harry10086/InkWord_ESP32/HW/InkWordESP32_MB_V1.1/jlcpcb/production_files/BOM-InkWordESP32_MB_V1.1.csv

Comment | Designator | Footprint | LCSC | Quantity
0R | R7,R8 | R0603 | C100044 | 2
100nF ±10% 50V | C1,C11,C2,C20,C22,C24,C25,C26,C27,C35,C37,C6,C7 | C0603 | C14663 | 13
100uH | L1 | LQH3NPZ101MMEL | C703088 | 1
10kΩ | R13,R14,R15,R16,R17,R18,R22,R26,R29,R30,R34,R38,R4,R6,R9 | R0603 | C25804 | 15
10uF 10V | C10,C13,C21,C23,C3 | C0603 | C19702 | 5
10uF 50V | C19 | C0805 | C2932476 | 1
10Ω | R19,R20,R21,R23,R24,R25,R36,R37 | R0603 | C109318 | 8
1MΩ ±1% | R12 | R0603 | C22935 | 1
1kΩ | R1 | R0603 | C22548 | 1
1uF | C12,C14,C15,C16,C17,C4,C5,C8,C9 | C0603 | C15849 | 9
33Ω | R27 | R0603 | C23140 | 1
3MΩ ±1% | R11 | R0603 | C23156 | 1
3kΩ ±1% | R5 | R0603 | C4211 | 1
3Ω | R10 | R0603 | C22356394 | 1
4.7uF | C18 | C0603 | C69335 | 1
5.1kΩ ±1% | R2,R3 | R0603 | C23186 | 2
600Ω@100MHz | FB1 | L0603 | C1002 | 1
AFC04-S24FCA-00 | FPC1 | AFC04-S24FCA-00 | C883632 | 1
B5819WS | D4,D5,D6 | B5819WS | C7420331 | 3
BSMD0603L-100 | F1,F2 | Fuse_0603_1608Metric | C2757929 | 2
ESP32-S3-WROOM-1_N16R8 | U4 | ESP32-S3-WROOM-1_N16R8 | C2913202 | 1
GT-L5.2-W5.2-H015 | SW1,SW2 | SW-SMD_4P-L5.2-W5.2-P3.70-LS6.4 | C29780122 | 2
RCLAMP0521P-N | D10,D11,D12,D13,D14,D15,D17,D7,D8,D9 | RCLAMP0521P-N | C316043 | 10
RCLAMP0521T-ES | D1,D2,D3 | DFN1006-2L | C5180263 | 3
SI1308EDL-T1-GE3 | Q1 | SI1308EDL-T1-GE3 | C469327 | 1
SS12D10G6-WJ | S1 | SS12D10G6-WJ | C7431059 | 1
TF-CARD_H1_8 | TF1 | TF-CARD_H1_8 | C7529389 | 1
TP4055 | U2 | SOT-23-5_L3.0-W1.7-P0.95-LS2.8-BL | C28441 | 1
TS-1009B-05026 | K1,K2,K3 | TS-1009B-05026 | C455252 | 3
TYPE-C16PIN | USB1 | TYPE-C16PIN | C393939 | 1
XB6366D | U1 | XB6366D | C2760016 | 1
XC6220B331MR-G | U3 | XC6220B331MR-G | C86534 | 1
ZX-XH2.54-2PWZ | CN1 | CONN-TH_2P-P2.50_ZX-XH2.54-2PWZ | C7429641 | 1
ZX-XH2.54-3PZZ |  | CONN-TH_3P-P2.54_2501S-3P | C7429633 | 0
