harry10086/InkWord_ESP32/MD/inkword_v1.1/InkWord-fastener.SLDPRT

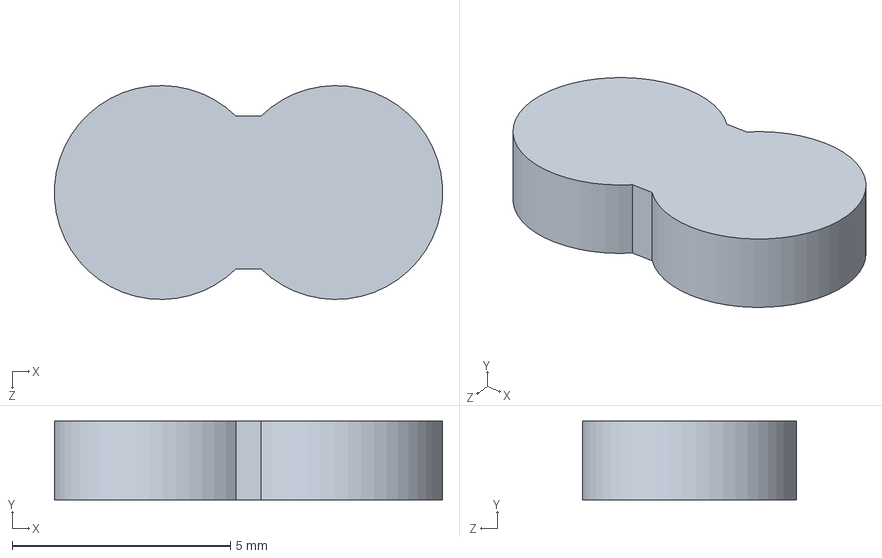
[picture p1: CAD file, 2026-10-13]
MD/inkword_v1.1/InkWord-fastener.SLDPRT
8.89 x 1.80 x 4.90 mm
