harry10086/InkWord_ESP32/MD/inkword_v1.1/InkWord-bottom.SLDPRT

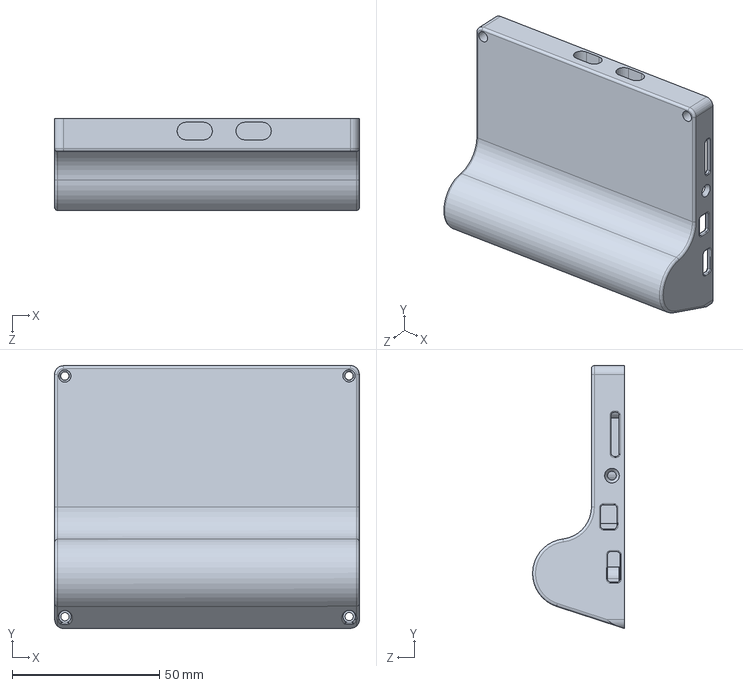
[picture p2: CAD file, 2026-10-13]
MD/inkword_v1.1/InkWord-bottom.SLDPRT
103.6 x 89.3 x 31.2 mm
