harry10086/InkWord_ESP32/MD/inkword_v1.1/InkWord-top.SLDPRT

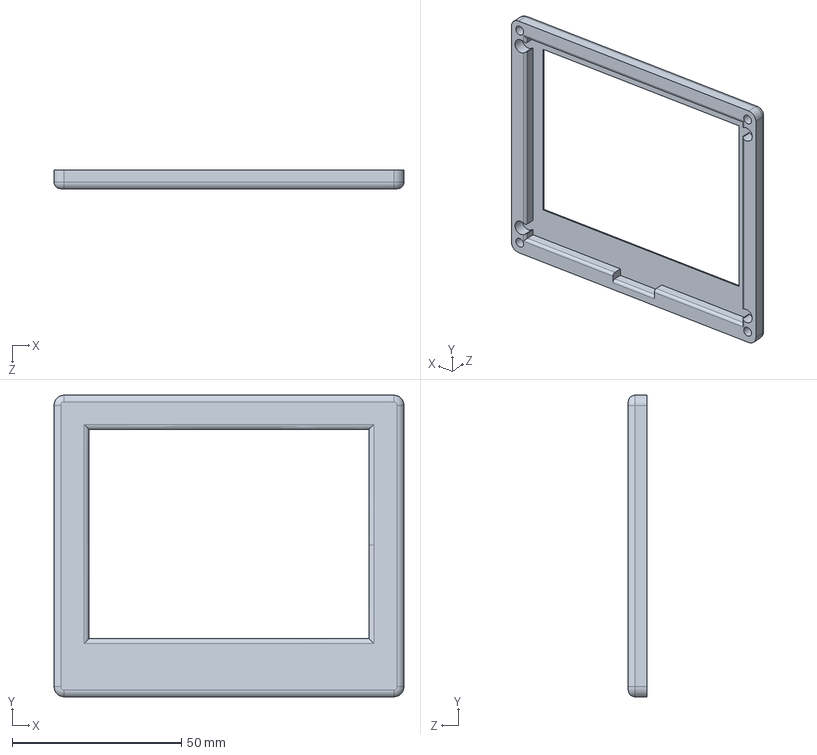
[picture p3: CAD file, 2026-10-13]
MD/inkword_v1.1/InkWord-top.SLDPRT
103.5 x 89.3 x 5.50 mm
