harry10086/InkWord_ESP32/MD/inkword_v1.1/InkWord-spring.SLDPRT

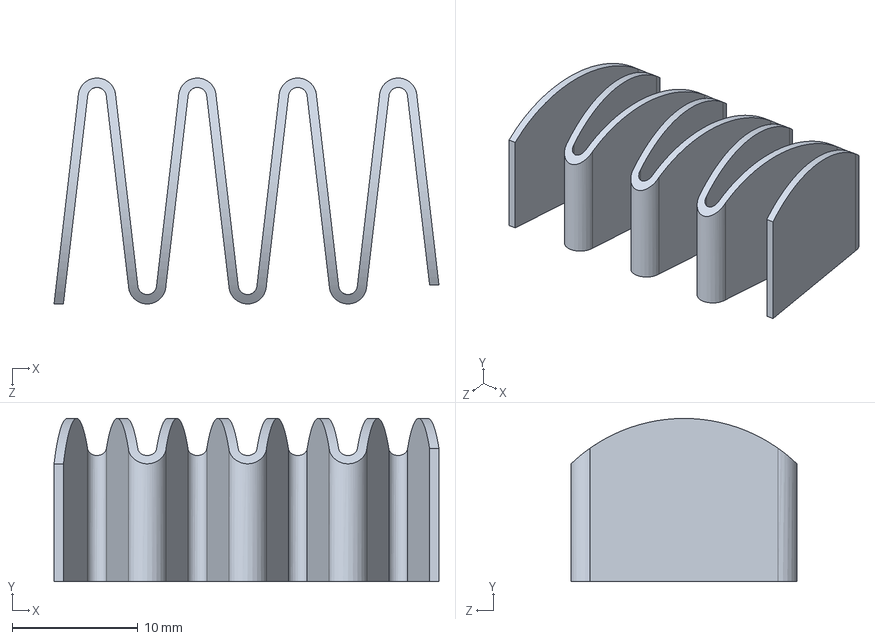
[picture p4: CAD file, 2026-10-13]
MD/inkword_v1.1/InkWord-spring.SLDPRT
30.7 x 13.0 x 18.0 mm
