harry10086/InkWord_ESP32/MD/inkword_v1.1/InkWord-button.SLDPRT

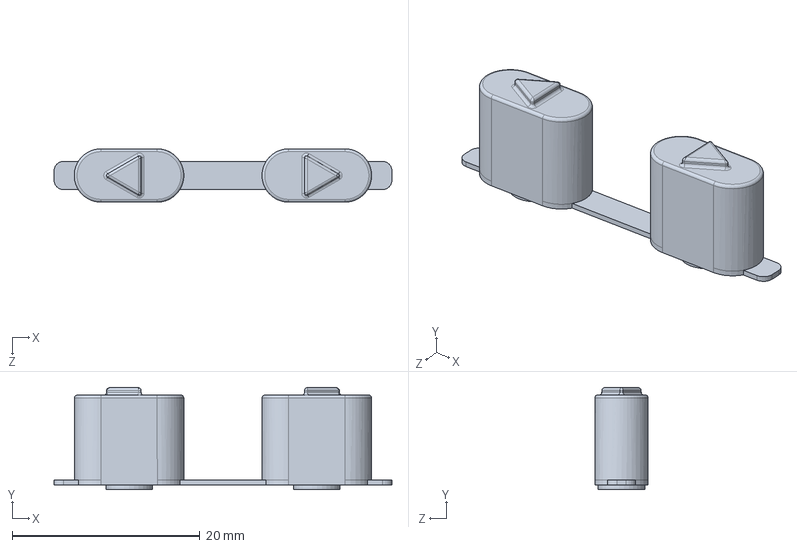
[picture p5: CAD file, 2026-10-13]
MD/inkword_v1.1/InkWord-button.SLDPRT
36.0 x 10.9 x 5.68 mm
