harry10086/InkWord_ESP32/MD/inkword_v1.1/ink.SLDPRT

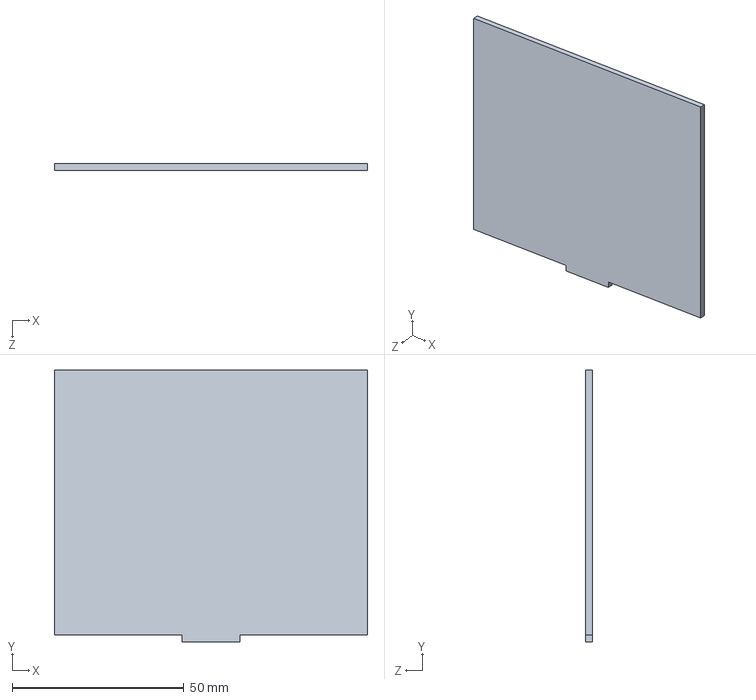
[picture p6: CAD file, 2026-10-13]
MD/inkword_v1.1/ink.SLDPRT
91.0 x 79.0 x 1.90 mm
