harry10086/InkWord_ESP32/HW/InkWordESP32_MB_V1.1/InkWordESP32_MB_V1.1.kicad_pcb

## KiCad design HW/InkWordESP32_MB_V1.1/InkWordESP32_MB_V1.1.kicad_pcb (2026-10-13)

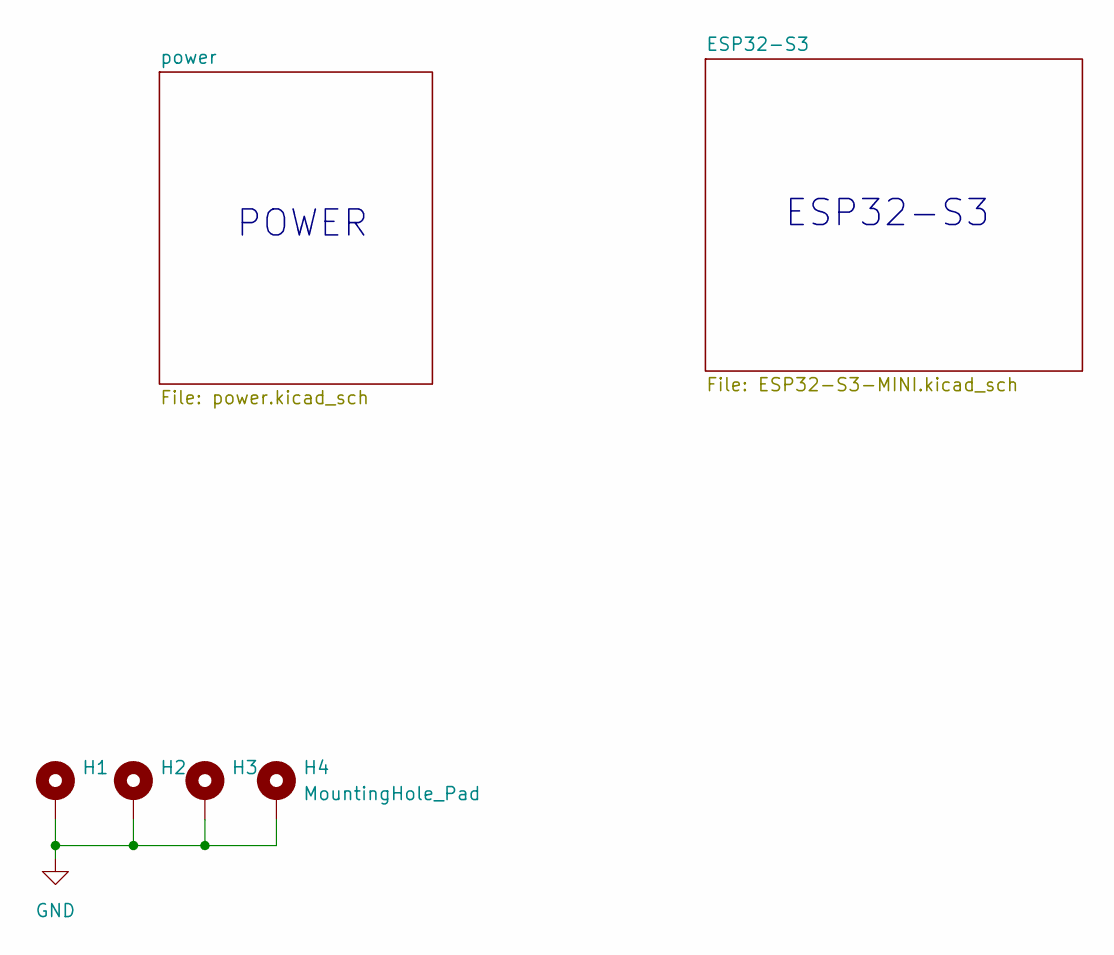
[picture p7: schematic InkWordESP32_MB_V1.1.kicad_sch]

Parts:
H1, H2, H3, H4: MountingHole_Pad; MountingHole_3.2mm_M3_Pad_Via

Connections:
GND: H1.1 (1_1), H2.1 (1_1), H3.1 (1_1), H4.1 (1_1); also elsewhere on the board

Notes on the sheet:
POWER
ESP32-S3

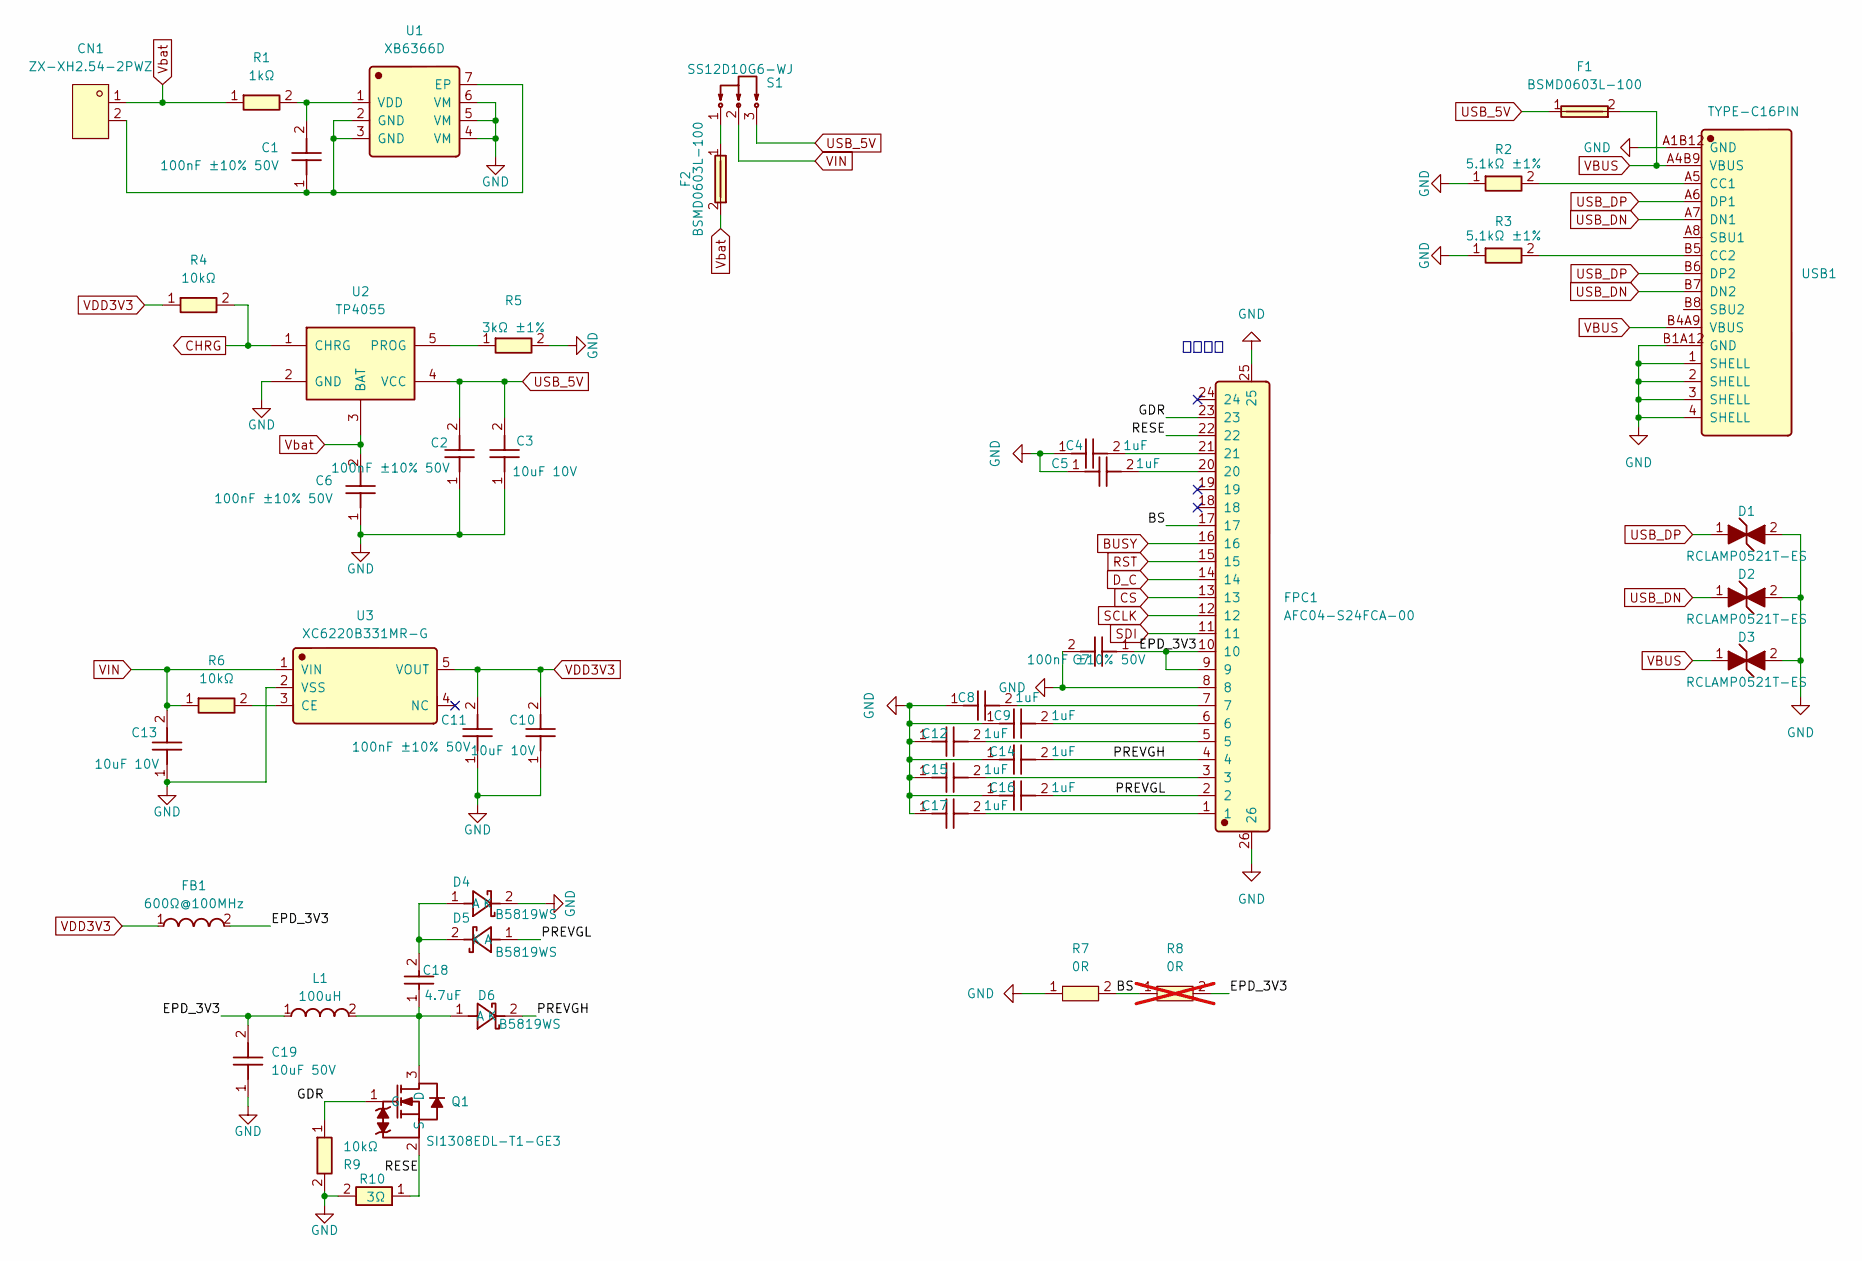
[picture p8: schematic power.kicad_sch]

Parts:
C1, C2, C6, C7, C11: 100nF ±10% 50V; C0603; Manufacturer Part CC0603KRX7R9BB104; LCSC C14663
C3, C10, C13: 10uF 10V; C0603; Manufacturer Part CL10A106KP8NNNC; LCSC C19702
C4, C5, C8, C9, C12, C14, C15, C16, C17: 1uF; C0603; Manufacturer Part CL10A105KB8NNNC; LCSC C15849
C18: 4.7uF; C0603; Manufacturer Part CL10A475KA8NQNC; LCSC C69335
C19: 10uF 50V; C0805; Manufacturer Part CL21A106KBYQNNE; LCSC C2932476
CN1: ZX-XH2.54-2PWZ; CONN-TH_2P-P2.50_ZX-XH2.54-2PWZ; LCSC Part C7429641
D1, D2, D3: RCLAMP0521T-ES; DFN1006-2L; Manufacturer Part RCLAMP0521T-ES; LCSC C5180263
D4, D5, D6: B5819WS; Manufacturer Part B5819WS; LCSC C7420331
F1, F2: BSMD0603L-100; Fuse_0603_1608Metric; Manufacturer Part BSMD0603L-100; LCSC C2757929
FB1: 600Ω@100MHz; L0603; Manufacturer Part GZ1608D601TF; LCSC C1002
FPC1: AFC04-S24FCA-00; Manufacturer Part AFC04-S24FCA-00; LCSC C883632
L1: 100uH; LQH3NPZ101MMEL; Manufacturer Part LQH3NPZ101MMEL; LCSC C703088
Q1: SI1308EDL-T1-GE3; Manufacturer Part SI1308EDL-T1-GE3; LCSC C469327
R1: 1kΩ; R0603; Manufacturer Part 0603WAF1001T5E; LCSC C21190
R2, R3: 5.1kΩ ±1%; R0603; Manufacturer Part 0603WAF5101T5E; LCSC C23186
R4, R6, R9: 10kΩ; R0603; Manufacturer Part 0603WAF1002T5E; LCSC C25804
R5: 3kΩ ±1%; R0603; Manufacturer Part 0603WAF3001T5E; LCSC C4211
R7: 0R; R0603; LCSC Part C100044
R8: 0R; R0603; LCSC Part C100044; not fitted
R10: 3Ω; R0603; Manufacturer Part RCA033RFLF; LCSC C22356394
S1: SS12D10G6-WJ; Manufacturer Part SS12D10G6-WJ; LCSC C7431059
U1: XB6366D; Manufacturer Part XB6366D; LCSC C2760016
U2: TP4055; SOT-23-5_L3.0-W1.7-P0.95-LS2.8-BL; Manufacturer Part TP4055; LCSC C28441
U3: XC6220B331MR-G; Manufacturer Part XC6220B331MR-G; LCSC C86534
USB1: TYPE-C16PIN; Manufacturer Part TYPE-C16PIN; LCSC C393939

Connections:
/power/BS: FPC1.17, R7.2, R8.1
/power/EPD_3V3: C7.1, C19.2, FB1.2, FPC1.9, FPC1.10, L1.1, R8.2
/power/GDR: FPC1.23, Q1.1 (G), R9.1
/power/PREVGH: C14.2, D6.2 (K), FPC1.4
/power/PREVGL: C16.2, D5.1 (A), FPC1.2
/power/RESE: FPC1.22, Q1.2 (S), R10.1
BUSY: FPC1.16; also elsewhere on the board
CHRG: R4.2, U2.1 (CHRG); also elsewhere on the board
CS: FPC1.13; also elsewhere on the board
D_C: FPC1.14; also elsewhere on the board
GND: C2.1, C3.1, C4.1, C5.1, C6.1, C7.2, C8.1, C9.1, C10.1, C11.1, C12.1, C13.1, C14.1, C15.1, C16.1, C17.1, C19.1, D1.2, D2.2, D3.2, D4.2 (K), FPC1.8, FPC1.25, FPC1.26, R2.1, R3.1, R5.2, R7.1, R9.2, R10.2, U1.4 (VM), U1.5 (VM), U1.6 (VM), U2.2 (GND), U3.2 (VSS), USB1.1 (SHELL), USB1.2 (SHELL), USB1.3 (SHELL), USB1.4 (SHELL), USB1.A1B12 (GND), USB1.B1A12 (GND); also elsewhere on the board
unnamed: C4.2, FPC1.21
unnamed: C5.2, FPC1.20
unnamed: C8.2, FPC1.7
unnamed: C9.2, FPC1.6
unnamed: C12.2, FPC1.5
unnamed: C15.2, FPC1.3
unnamed: C17.2, FPC1.1
unnamed: C18.2, D4.1 (A), D5.2 (K)
unnamed: C18.1, D6.1 (A), L1.2, Q1.3 (D)
unnamed: F2.1, S1.1
unnamed: C1.1, CN1.2, U1.2 (GND), U1.3 (GND), U1.7 (EP)
unnamed: C1.2, R1.2, U1.1 (VDD)
unnamed: R5.1, U2.5 (PROG)
unnamed: R6.2, U3.3 (CE)
unnamed: R2.2, USB1.A5 (CC1)
unnamed: R3.2, USB1.B5 (CC2)
RST: FPC1.15; also elsewhere on the board
SCLK: FPC1.12; also elsewhere on the board
SDI: FPC1.11; also elsewhere on the board
USB_5V: C2.2, C3.2, F1.1, S1.3, U2.4 (VCC)
USB_DN: D2.1, USB1.A7 (DN1), USB1.B7 (DN2); also elsewhere on the board
USB_DP: D1.1, USB1.A6 (DP1), USB1.B6 (DP2); also elsewhere on the board
VBUS: D3.1, F1.2, USB1.A4B9 (VBUS), USB1.B4A9 (VBUS)
VDD3V3: C10.2, C11.2, FB1.1, R4.1, U3.5 (VOUT); also elsewhere on the board
VIN: C13.2, R6.1, S1.2, U3.1 (VIN); also elsewhere on the board
Vbat: C6.2, CN1.1, F2.2, R1.1, U2.3 (BAT)

Notes on the sheet:
排线下接

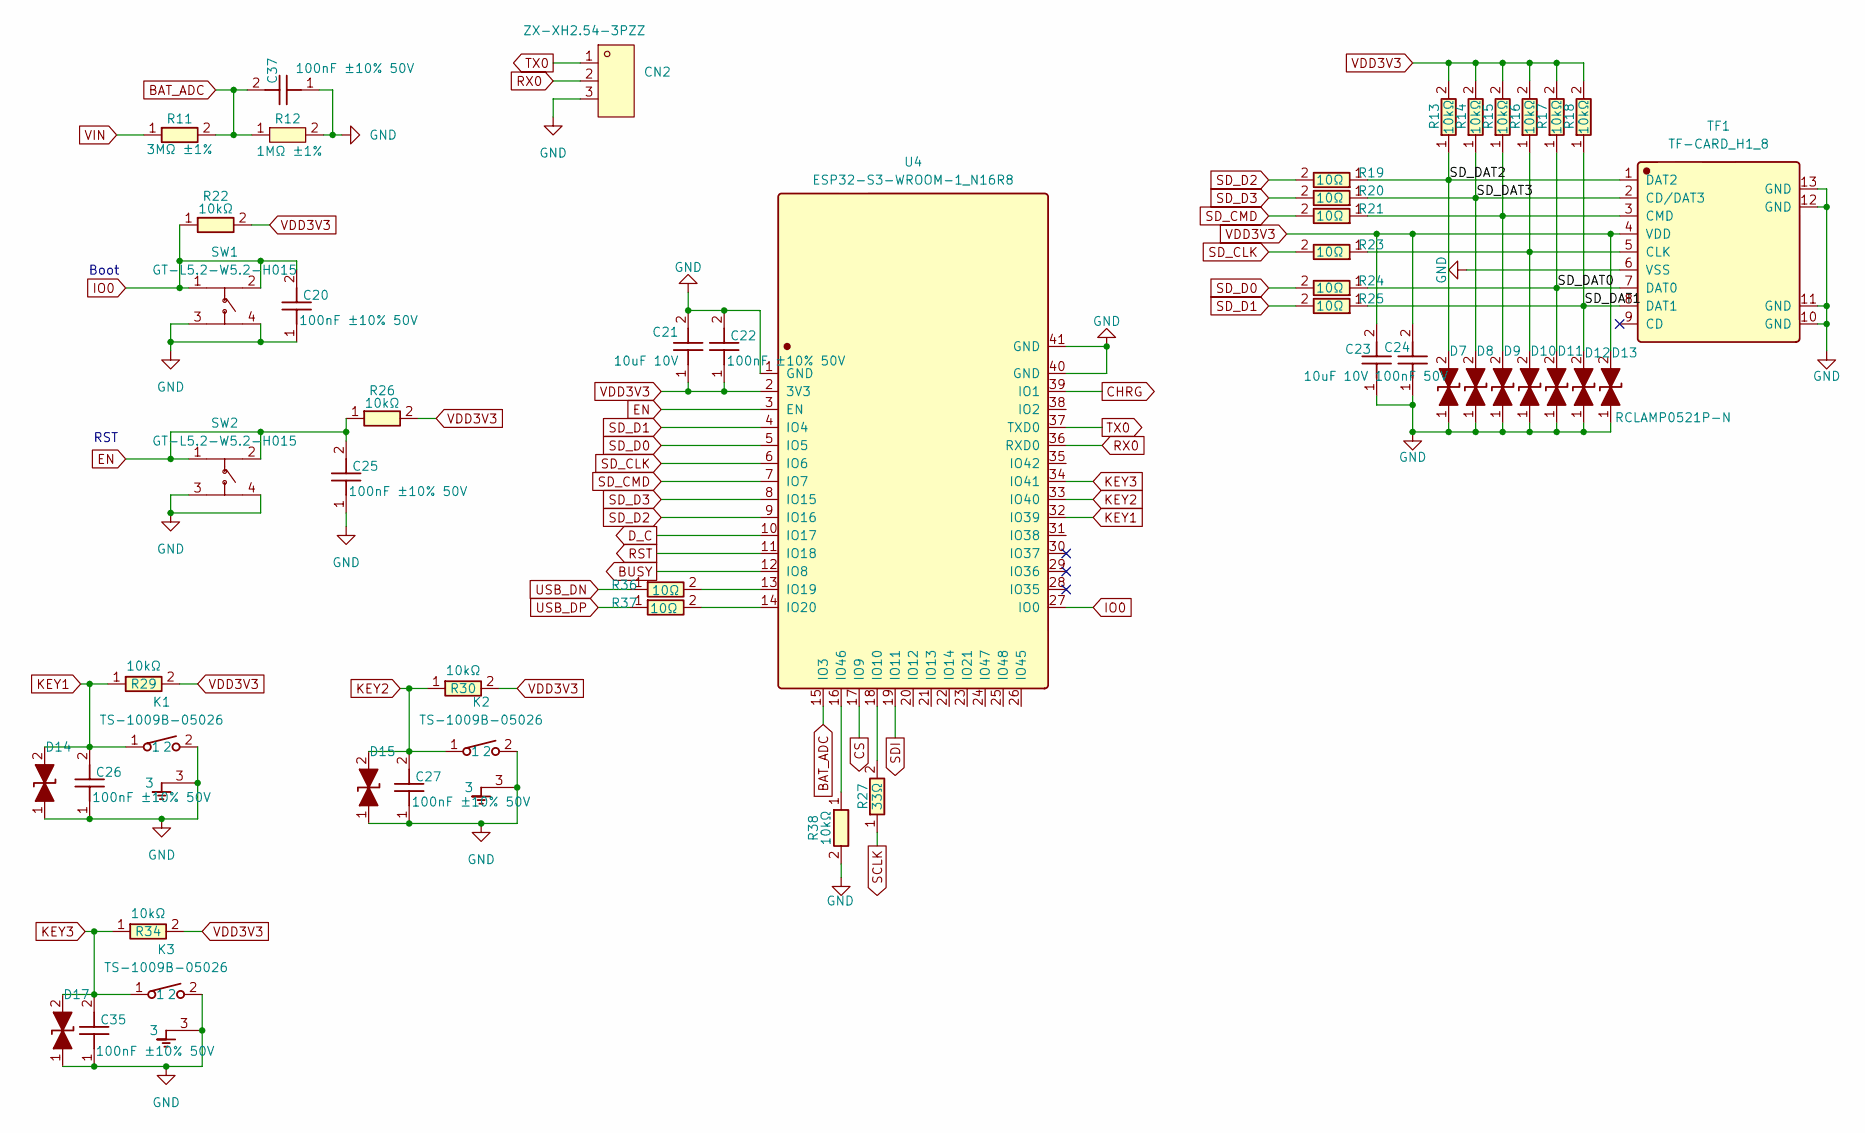
[picture p9: schematic ESP32-S3-MINI.kicad_sch]

Parts:
C20, C22, C25, C26, C27, C35, C37: 100nF ±10% 50V; C0603; Manufacturer Part CC0603KRX7R9BB104; LCSC C14663
C21, C23: 10uF 10V; C0603; Manufacturer Part CL10A106KP8NNNC; LCSC C19702
C24: 100nF 50V; C0603; Manufacturer Part CC0603KRX7R9BB104; LCSC C14663
CN2: ZX-XH2.54-3PZZ; CONN-TH_3P-P2.54_2501S-3P; LCSC Part C7429633
D7, D8, D9, D10, D11, D12, D13, D14, D15, D17: RCLAMP0521P-N; Manufacturer Part RCLAMP0521P-N; LCSC C316043
K1, K2, K3: TS-1009B-05026; Manufacturer Part TS-1009B-05026; LCSC C455252
R11: 3MΩ ±1%; R0603; Manufacturer Part 0603WAF3004T5E; LCSC C23156
R12: 1MΩ ±1%; R0603; LCSC Part C22935
R13, R14, R15, R16, R17, R18, R22, R26, R29, R30, R34, R38: 10kΩ; R0603; Manufacturer Part 0603WAF1002T5E; LCSC C25804
R19, R20, R21, R23, R24, R25, R36, R37: 10Ω; R0603; Manufacturer Part RC0603FR-0710RL; LCSC C109318
R27: 33Ω; R0603; Manufacturer Part 0603WAF330JT5E; LCSC C23140
SW1, SW2: GT-L5.2-W5.2-H015; SW-SMD_4P-L5.2-W5.2-P3.70-LS6.4; LCSC Part C29780122
TF1: TF-CARD_H1_8; Manufacturer Part TF-CARD H1.8; LCSC C7529389
U4: ESP32-S3-WROOM-1_N16R8; Manufacturer Part ESP32-S3-WROOM-1-N16R8; LCSC C2913202

Connections:
/ESP32-S3-MINI/SD_DAT0: D11.2, R17.1, R24.1, TF1.7 (DAT0)
/ESP32-S3-MINI/SD_DAT1: D12.2, R18.1, R25.1, TF1.8 (DAT1)
/ESP32-S3-MINI/SD_DAT2: D7.2, R13.1, R19.1, TF1.1 (DAT2)
/ESP32-S3-MINI/SD_DAT3: D8.2, R14.1, R20.1, TF1.2 (CD/DAT3)
BAT_ADC: C37.2, R11.2, R12.1, U4.15 (IO3)
BUSY: U4.12 (IO8); also elsewhere on the board
CHRG: U4.39 (IO1); also elsewhere on the board
CS: U4.17 (IO9); also elsewhere on the board
D_C: U4.10 (IO17); also elsewhere on the board
EN: C25.2, R26.1, SW2.1, SW2.2, U4.3 (EN)
GND: C20.1, C21.2, C22.2, C23.1, C24.1, C25.1, C26.1, C27.1, C35.1, C37.1, CN2.3, D7.1, D8.1, D9.1, D10.1, D11.1, D12.1, D13.1, D14.1, D15.1, D17.1, K1.2, K1.3, K2.2, K2.3, K3.2, K3.3, R12.2, R38.2, SW1.3, SW1.4, SW2.3, SW2.4, TF1.6 (VSS), TF1.10 (GND), TF1.11 (GND), TF1.12 (GND), TF1.13 (GND), U4.1 (GND), U4.40 (GND), U4.41 (GND); also elsewhere on the board
IO0: C20.2, R22.1, SW1.1, SW1.2, U4.27 (IO0)
KEY1: C26.2, D14.2, K1.1, R29.1, U4.32 (IO39)
KEY2: C27.2, D15.2, K2.1, R30.1, U4.33 (IO40)
KEY3: C35.2, D17.2, K3.1, R34.1, U4.34 (IO41)
unnamed: D10.2, R16.1, R23.1, TF1.5 (CLK)
unnamed: D9.2, R15.1, R21.1, TF1.3 (CMD)
unnamed: R27.2, U4.18 (IO10)
unnamed: R36.2, U4.13 (IO19)
unnamed: R37.2, U4.14 (IO20)
unnamed: R38.1, U4.16 (IO46)
RST: U4.11 (IO18); also elsewhere on the board
RX0: CN2.2, U4.36 (RXD0)
SCLK: R27.1; also elsewhere on the board
SDI: U4.19 (IO11); also elsewhere on the board
SD_CLK: R23.2, U4.6 (IO6)
SD_CMD: R21.2, U4.7 (IO7)
SD_D0: R24.2, U4.5 (IO5)
SD_D1: R25.2, U4.4 (IO4)
SD_D2: R19.2, U4.9 (IO16)
SD_D3: R20.2, U4.8 (IO15)
TX0: CN2.1, U4.37 (TXD0)
USB_DN: R36.1; also elsewhere on the board
USB_DP: R37.1; also elsewhere on the board
VDD3V3: C21.1, C22.1, C23.2, C24.2, D13.2, R13.2, R14.2, R15.2, R16.2, R17.2, R18.2, R22.2, R26.2, R29.2, R30.2, R34.2, TF1.4 (VDD), U4.2 (3V3); also elsewhere on the board
VIN: R11.1; also elsewhere on the board

Notes on the sheet:
RST
Boot

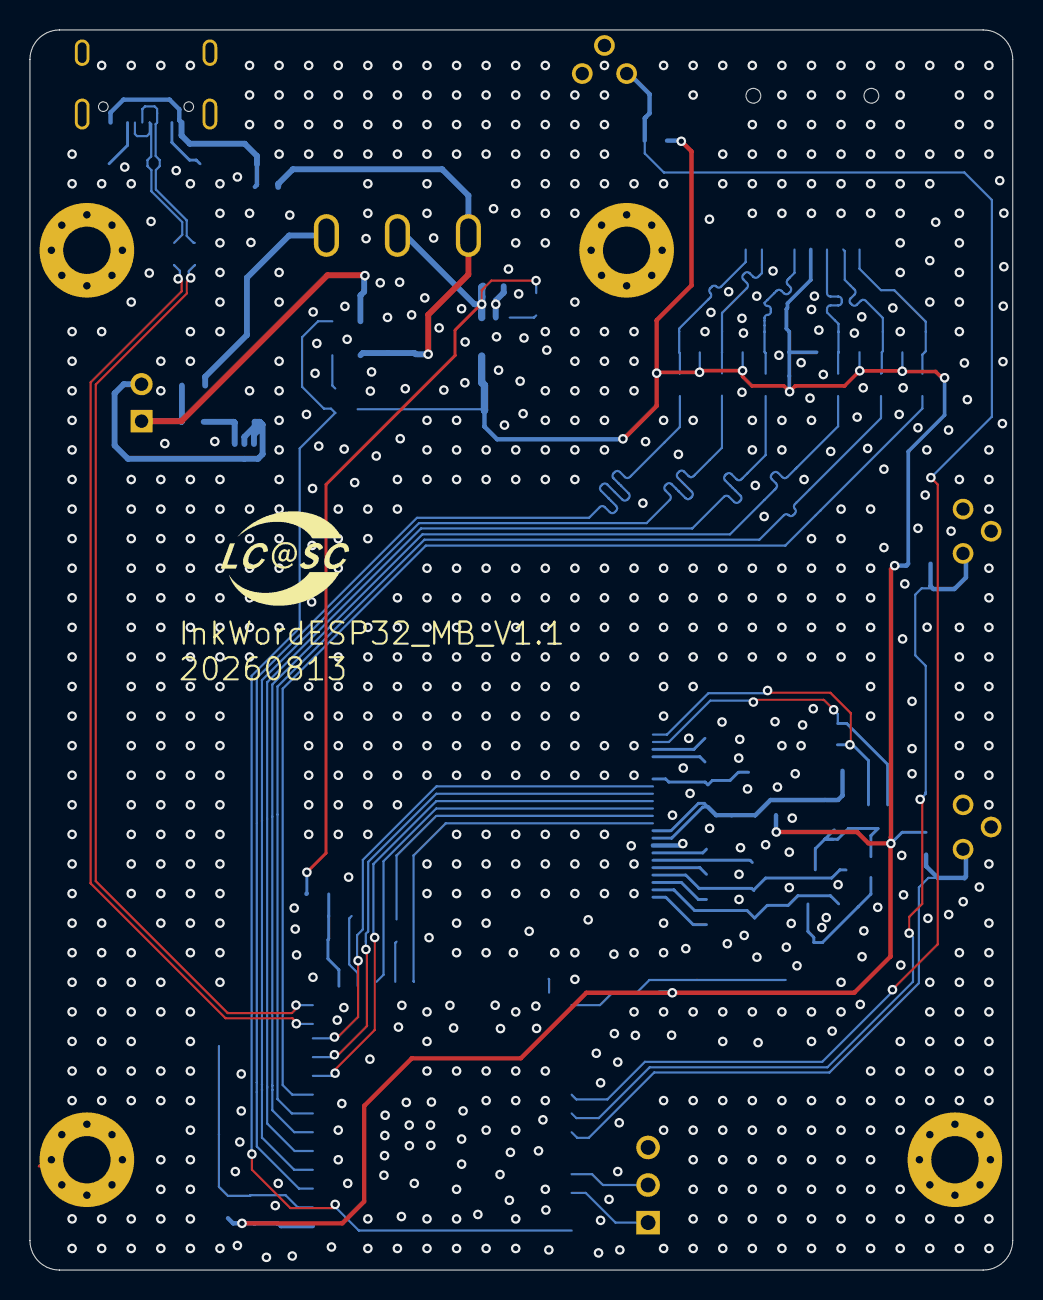
[picture p10: board InkWordESP32_MB_V1.1.kicad_pcb from above]

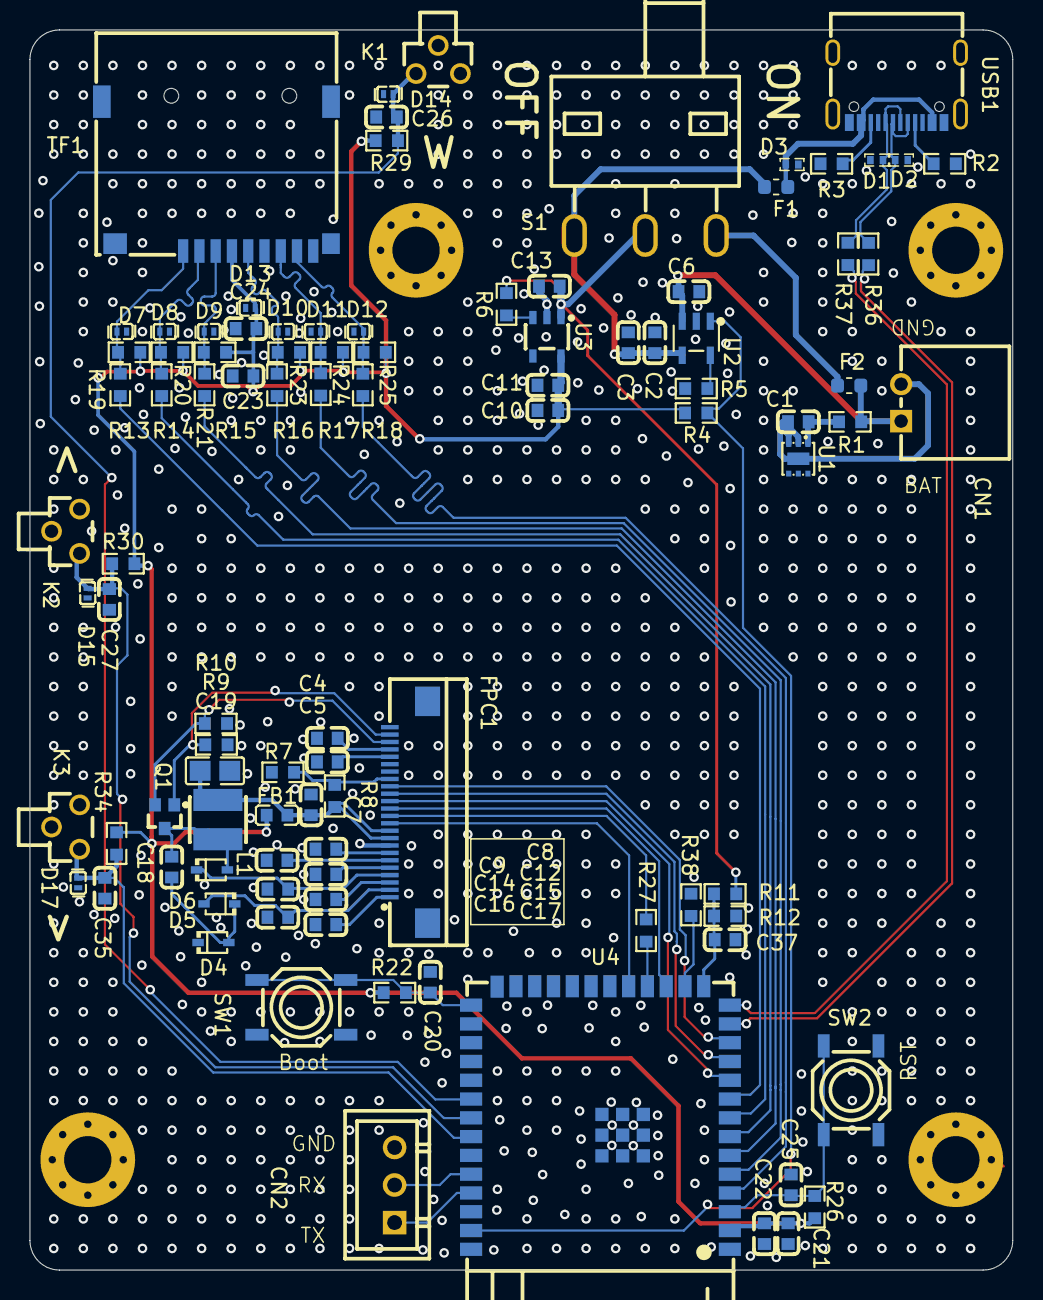
[picture p11: board InkWordESP32_MB_V1.1.kicad_pcb from below]

Board: 2 copper layers, 66.5 x 83.9 mm, 102 parts (98 on the bottom side), 61 nets.
