harry10086/InkWord_ESP32/(notices)

Notices in the files:
README.md:
License: GPL v3
